RossPorter506/LED_Dimmer/README.md

# LED_Dimmer
Schematic and PCB layout for a dumb 5-12V LED dimming circuit, capable of 2-99% PWM-based dimming.

No MCUs, no intelligent internet-connected devices, just a good old fashioned analog PWM dimmer using a 555 timer and a potentiometer.
