RossPorter506/LED_Dimmer/Images/Polarity_marking_center_negative.png

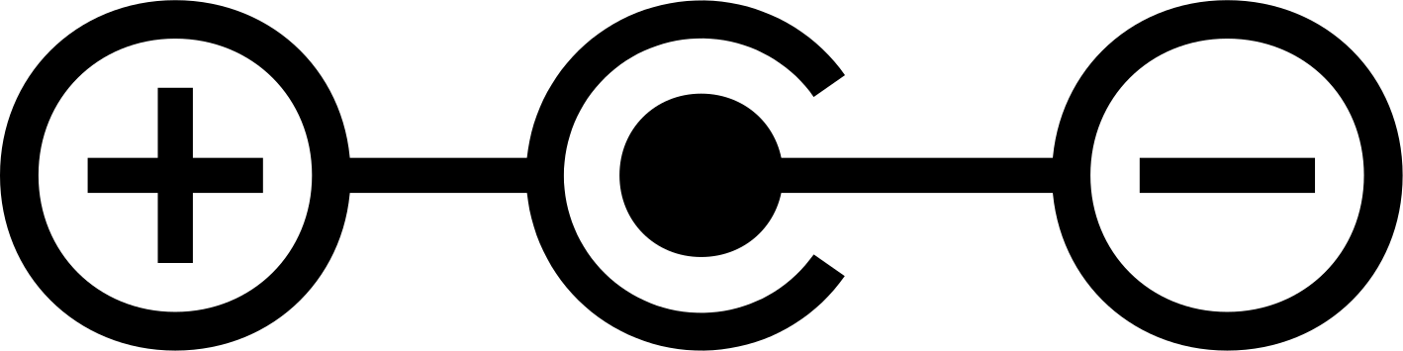
Images/Polarity_marking_center_negative.png
