RossPorter506/LED_Dimmer/Images/Polarity_marking_center_positive.png

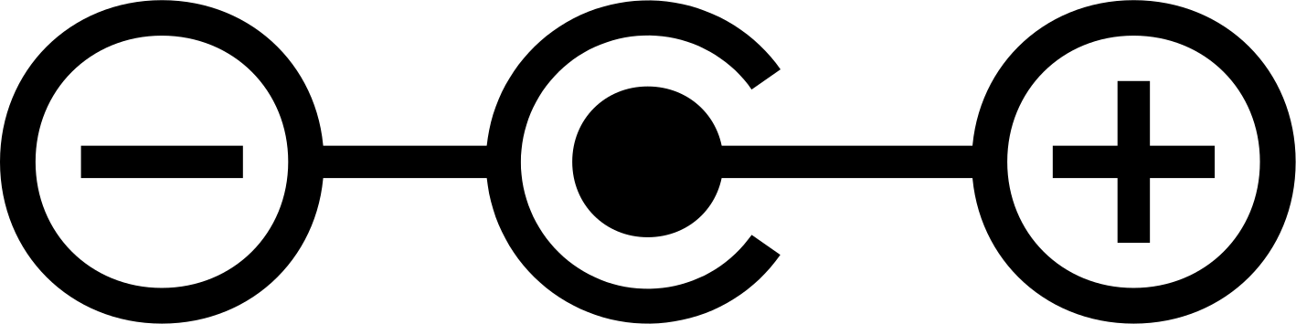
Images/Polarity_marking_center_positive.png
