RossPorter506/LED_Dimmer/3D models/PTV09A-4015F-B103--3DModel-STEP-269445.STEP

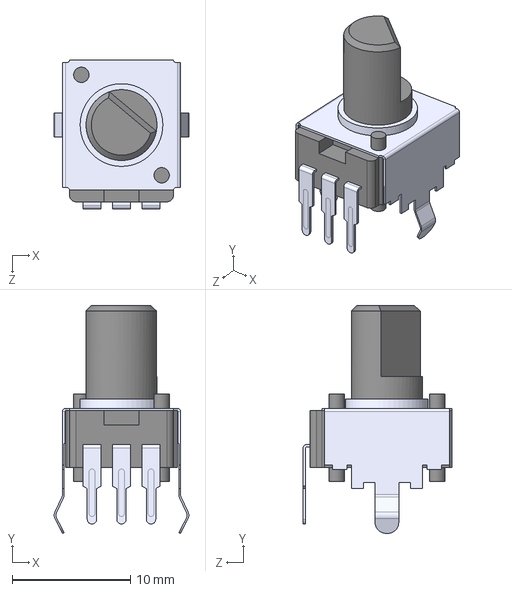
[picture p3: CAD file, 2025-07-15]
3D models/PTV09A-4015F-B103--3DModel-STEP-269445.STEP
11.4 x 19.3 x 12.6 mm
