RossPorter506/LED_Dimmer/SchematicSim.asc

C1: cap; 100n
C2: cap; 200p
D1: diode; 1N4148
D2: diode; 1N4148
M1: nmos; Si4800DY
PotX: res; 470k
PotY: res; 470k
R1: res; 10k
R2: res; 1k
R3: res; 8
V2: voltage; 12
X1: TLC555
Named nets: 0, Vcc, OUT, THRES
.tran 0 0.1 1m
.include TLC555.LIB
.PARAM Vt=25m
