RossPorter506/LED_Dimmer/LED_Dimmer.kicad_pcb

## KiCad design LED_Dimmer.kicad_pcb (2025-08-21)

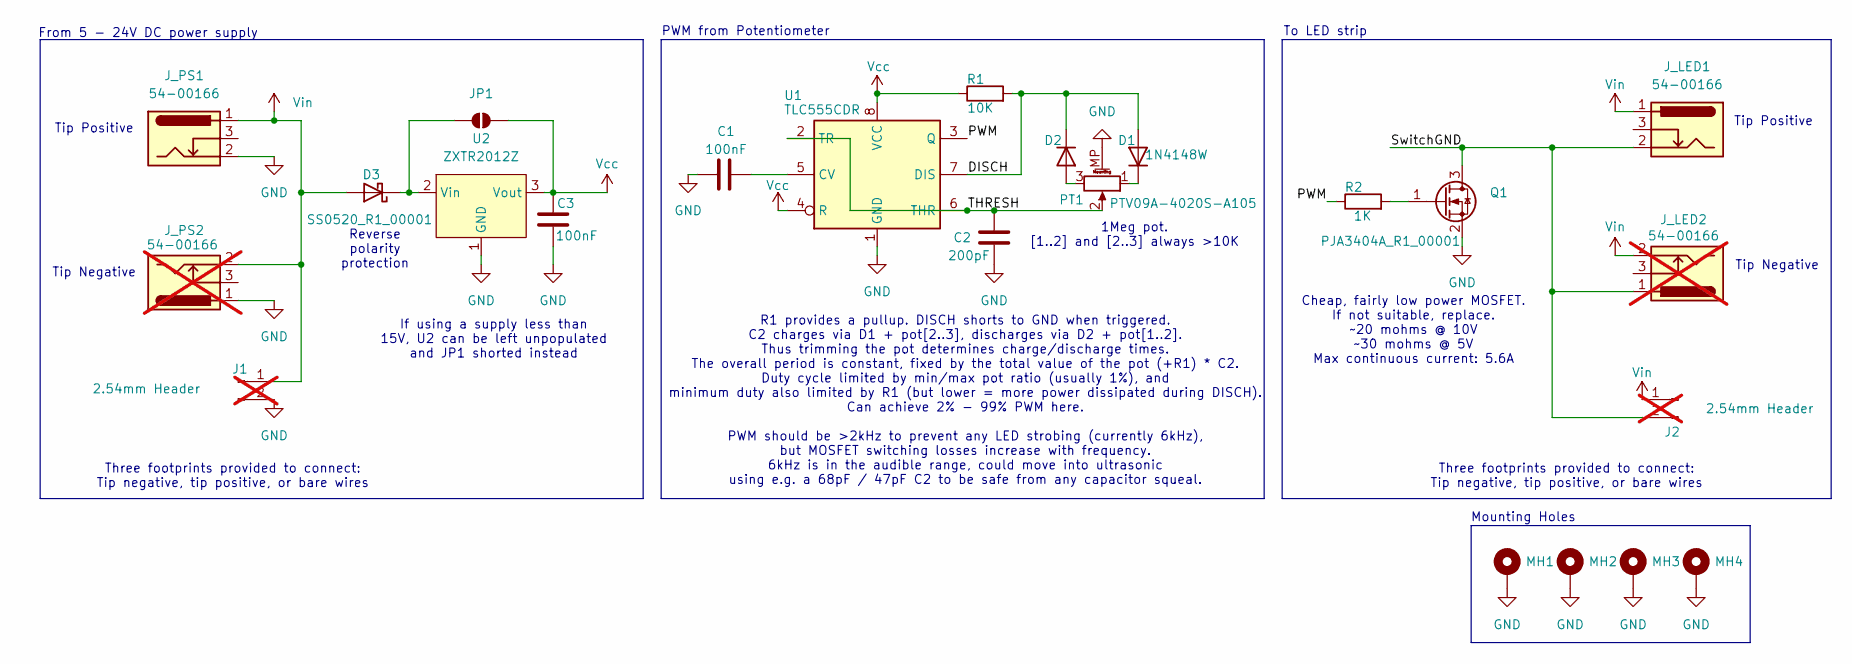
[picture p4: schematic LED_Dimmer.kicad_sch]

Parts:
C1, C3: 100nF; C_0805_2012Metric_Pad1.18x1.45mm_HandSolder
C2: 200pF; C_0805_2012Metric_Pad1.18x1.45mm_HandSolder
D1, D2: 1N4148W; D_SOD-123
D3: SS0520_R1_00001; D_SOD-123
J1, J2: 2.54mm Header; PinHeader_1x02_P2.54mm_Vertical; not fitted
JP1: SolderJumper_2_Open; SolderJumper-2_P1.3mm_Open_RoundedPad1.0x1.5mm
J_LED1: 54-00166; BarrelJack_GCT_DCJ200-10-A_Horizontal
J_LED2: 54-00166; BarrelJack_GCT_DCJ200-10-A_Horizontal; not fitted
J_PS1: 54-00166; BarrelJack_GCT_DCJ200-10-A_Horizontal
J_PS2: 54-00166; BarrelJack_GCT_DCJ200-10-A_Horizontal; not fitted
MH1, MH2, MH3, MH4: MountingHole_Pad; MountingHole_2.2mm_M2_Pad
PT1: PTV09A-4020S-A105; Potentiometer_Bourns_PTV09A-1_Single_Vertical
Q1: PJA3404A_R1_00001; SOT-23-3
R1: 10K; R_0805_2012Metric_Pad1.20x1.40mm_HandSolder
R2: 1K; R_0805_2012Metric_Pad1.20x1.40mm_HandSolder
U1: TLC555CDR; SOIC-8_3.9x4.9mm_P1.27mm
U2: ZXTR2012Z; SOT-89-3

Connections:
/DISCH: D1.2 (A), D2.1 (K), R1.2, U1.7 (DIS)
/PWM: R2.1, U1.3 (Q)
/SwitchGND: J2.2, J_LED1.2, J_LED2.1, Q1.3 (D)
/THRESH: C2.1, PT1.2, U1.2 (TR), U1.6 (THR)
GND: C1.1, C2.2, C3.1, J1.2, J_PS1.2, J_PS2.1, MH1.1, MH2.1, MH3.1, MH4.1, PT1.MP (MountPin), Q1.2 (S), U1.1 (GND), U2.1 (GND)
unnamed: D1.1 (K), PT1.1
unnamed: D2.2 (A), PT1.3
unnamed: D3.1 (K), JP1.1 (A), U2.2 (Vin)
unnamed: Q1.1 (G), R2.2
unnamed: C1.2, U1.5 (CV)
Vcc: C3.2, JP1.2 (B), R1.1, U1.4 (R), U1.8 (VCC), U2.3 (Vout)
Vin: D3.2 (A), J1.1, J2.1, J_LED1.1, J_LED2.2, J_PS1.1, J_PS2.2

Notes on the sheet:
Tip Positive
From 5 - 24V DC power supply
Tip Negative
To LED strip
If using a supply less than 15V, U2 can be left unpopulated and JP1 shorted instead
R1 provides a pullup. DISCH shorts to GND when triggered. C2 charges via D1 + pot[2..3], discharges via D2 + pot[1..2]. Thus trimming the pot determines charge/discharge times. The overall period is constant, fixed by the total value of the pot (+R1) * C2. Duty cycle limited by min/max pot ratio (u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
PWM from Potentiometer
Cheap, fairly low power MOSFET. If not suitable, replace. ~20 mohms @ 10V ~30 mohms @ 5V Max continuous current: 5.6A
Three footprints provided to connect: Tip negative, tip positive, or bare wires
1Meg pot. [1..2] and [2..3] always >10K
Reverse polarity protection
Mounting Holes

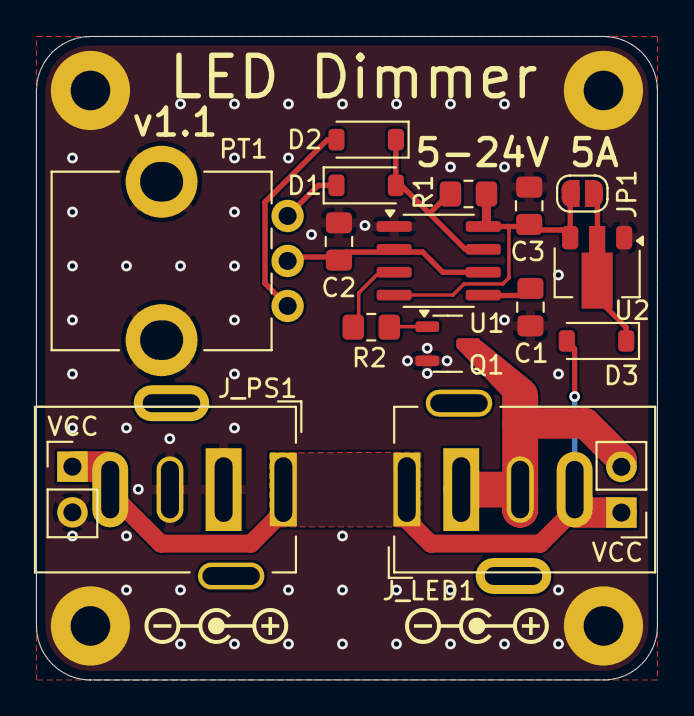
[picture p5: board LED_Dimmer.kicad_pcb from above]

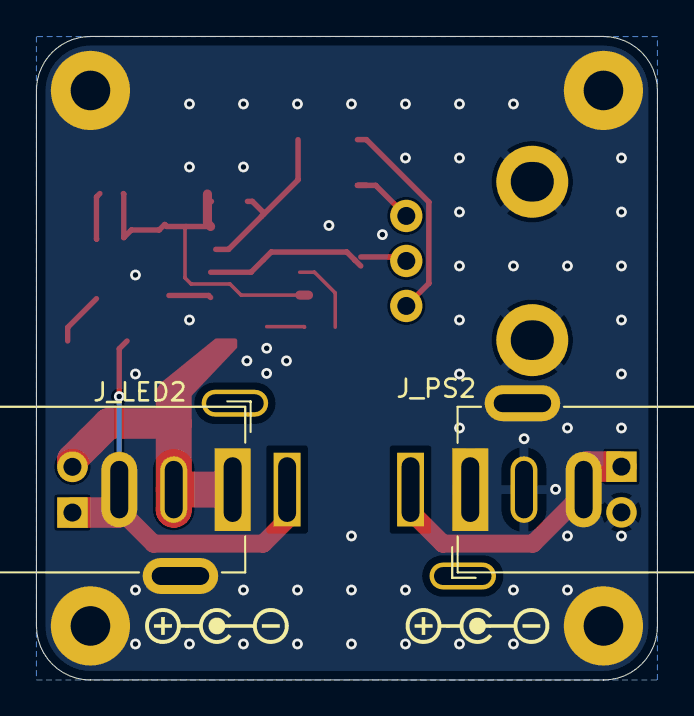
[picture p6: board LED_Dimmer.kicad_pcb from below]

Board: 2 copper layers, 34.5 x 35.8 mm, 27 parts (4 on the bottom side), 12 nets.

Other parts of the board:
G1_F, G1_F#2, G1_R, G2_R: LOGO
