RossPorter506/LED_Dimmer/(commit log)

2025-07-14 Start work
    [12V_LED_Dimmer.kicad_pcb, 12V_LED_Dimmer.kicad_sch]
2025-07-15 Add polarity images, pot footprint, tidy PCB
    Should work for 5V LEDs too, so change project name
    [12V_LED_Dimmer.kicad_pcb, 12V_LED_Dimmer.kicad_sch, LED_Dimmer.kicad_pcb, LED_Dimmer.kicad_sch, PTV09A-4015F-B103--3DModel-STEP-269445.STEP]
2025-07-15 Add Schottky part number
    [LED_Dimmer.kicad_sch]
2025-07-15 Tidy schematic, add serial number location to PCB
    [LED_Dimmer.kicad_pcb, LED_Dimmer.kicad_sch]
2025-07-15 Add Gerbers
    [LED_Dimmer-B_Mask.gbr, LED_Dimmer-B_Paste.gbr, LED_Dimmer-B_Silkscreen.gbr, LED_Dimmer-Back.gbr, LED_Dimmer-Edge_Cuts.gbr, LED_Dimmer-F_Mask.gbr, LED_Dimmer-F_Paste.gbr, LED_Dimmer-F_Silkscreen.gbr]
2025-07-15 Rename project
    [LED_Dimmer.kicad_sch]
2025-07-15 Fix diode part number
    [LED_Dimmer.kicad_pcb, LED_Dimmer.kicad_sch]
2025-08-21 Add current limiting resistor to FET
    [LED_Dimmer.kicad_pcb, LED_Dimmer.kicad_sch]
2025-08-21 Add optional regulator for 24V LEDs
    [LED_Dimmer.kicad_pcb, LED_Dimmer.kicad_sch]
2025-08-21 Fix MOSFET pin order
    [LED_Dimmer.kicad_pcb, LED_Dimmer.kicad_sch]
